nishanthr24-proj/PCB-desgning-/solar-charger-led-revB/ATTRIBUTION.md

# Sources and attribution

- Starting project: <https://github.com/Hirusha785/solar-battery-charge-controller-pcb>,
  archive supplied by the user, commit identifier in the ZIP:
  `8adcedc8ef8a8e4cd02e30468040b93200b75584`.
  Its README credits **Fernando S.M.H.G.** Rev A introduced a corrected schematic and PCB layout; Rev B adds
  input protection, test points, shutdown access, and clarified labels while
  preserving that lineage. The supplied
  archive does not include a license; no new license is asserted for upstream work.
- Revision lineage: Rev B is derived from the user's Rev A in this repository,
  retained at `../solar-charger-led-revA/` for comparison. The added engineering
  changes do not imply that any upstream author reviewed or endorsed Rev B.
- Circuit reference: Analog Devices / Linear Technology **LT3652**, datasheet
  revision `3652fe`, particularly pin functions, component selection, feedback
  compensation, status decoding, temperature monitoring, and layout guidance:
  <https://www.analog.com/media/en/technical-documentation/data-sheets/3652fe.pdf>.
  The official host was blocked by this environment's network policy. The same
  document was read from the public copy at
  <https://github.com/BEEMB/LT3652-MPPT-Solar-Battery-Charger/blob/main/Datasheets/LT3652.pdf>.
  Verify the latest manufacturer documentation and exact orderable part before assembly.
- SparkFun's SunnyBuddy LT3652 schematic was consulted to understand the uploaded
  circuit's origins: <https://github.com/sparkfun/SunnyBuddy>. Its Eagle geometry,
  artwork, and logos were not copied into this PCB. Do not imply either upstream
  author has reviewed or endorsed this revision.
- Local symbols and footprints are copies of standard **KiCad 9 libraries**,
  with project-local library nicknames. They retain the upstream library license
  and its exception. See the included `licenses/` copyright files. The project
  is not assigned a new license on the user's behalf.
- Bundled standard 3D models come from the official **KiCad packages3D** library,
  pinned to commit `b8b3cfdfad88ba66f21002b3de51dc6f7d55ba5a`:
  <https://gitlab.com/kicad/libraries/kicad-packages3D>.
  They retain **CC BY-SA 4.0 with the KiCad library design exception**; see
  [licenses/kicad-packages3D-LICENSE.md](licenses/kicad-packages3D-LICENSE.md).
  [3dmodels/SOURCES.json](3dmodels/SOURCES.json) records individual model sources.
  L1's locally created representative body and the representative U1 package
  dimensions are described in [3D/README.md](3D/README.md). These are visualization
  models, not manufacturer validation of the selected components.
- The user-supplied **DC-DC-Buck-converter-main.zip**, archive commit
  `8b01752160c50a88990ef84c027424b66262864f`, inspired the populated front/back
  presentation views. Its README credits **Nandeesh K S**. No reference-board
  geometry, artwork, or component model files were copied into Rev B.
- Protection components: F1 and D5 are specified by required ratings and package
  class. Verify the chosen fuse's DC voltage/interrupt ratings and land pattern,
  and the chosen diode's current/voltage/thermal ratings, against the actual
  manufacturer documents before purchase. No unverified manufacturer part number
  is asserted as a drop-in substitute.
- No LT3652 manufacturer simulation model was used for Rev B and no simulation
  result is presented as Rev B verification. Physical tests have not been performed.
