nishanthr24-proj/PCB-desgning-/solar-charger-led-revB/previews/PCB_3D_Top.png

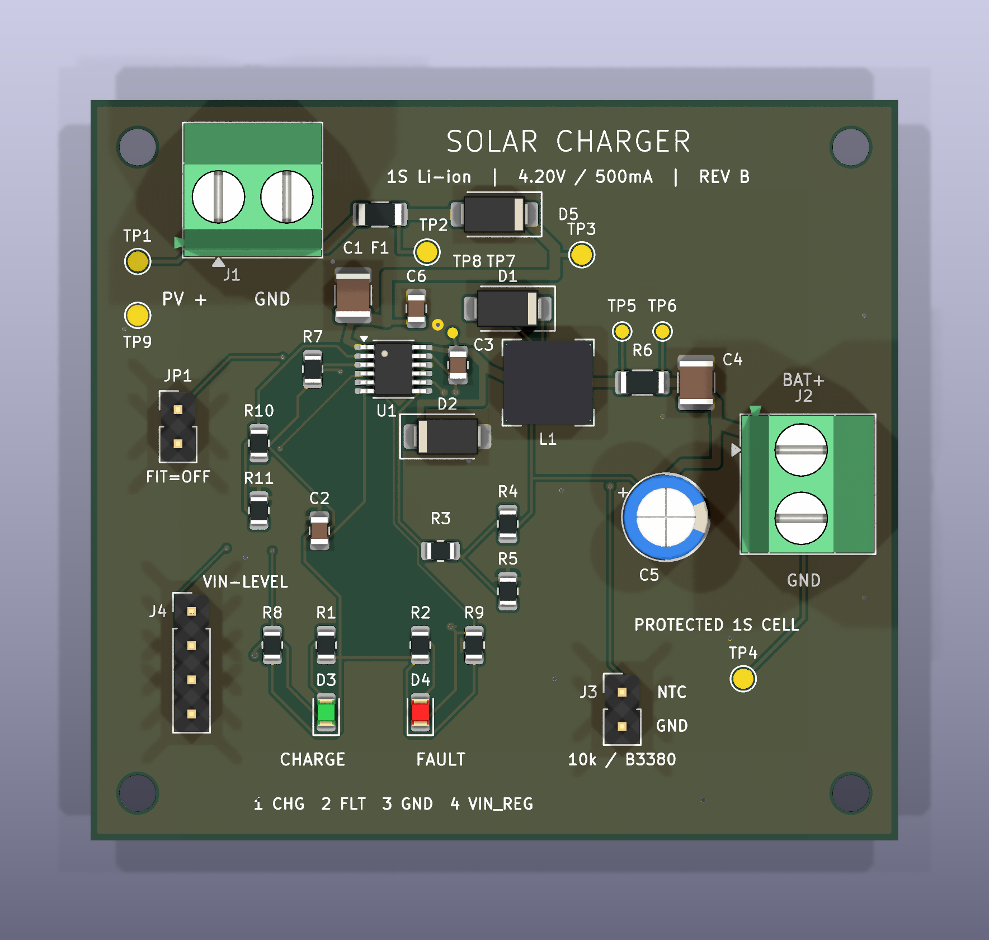
solar-charger-led-revB/previews/PCB_3D_Top.png
