nishanthr24-proj/PCB-desgning-/solar-charger-led-revB/previews/Schematic.png

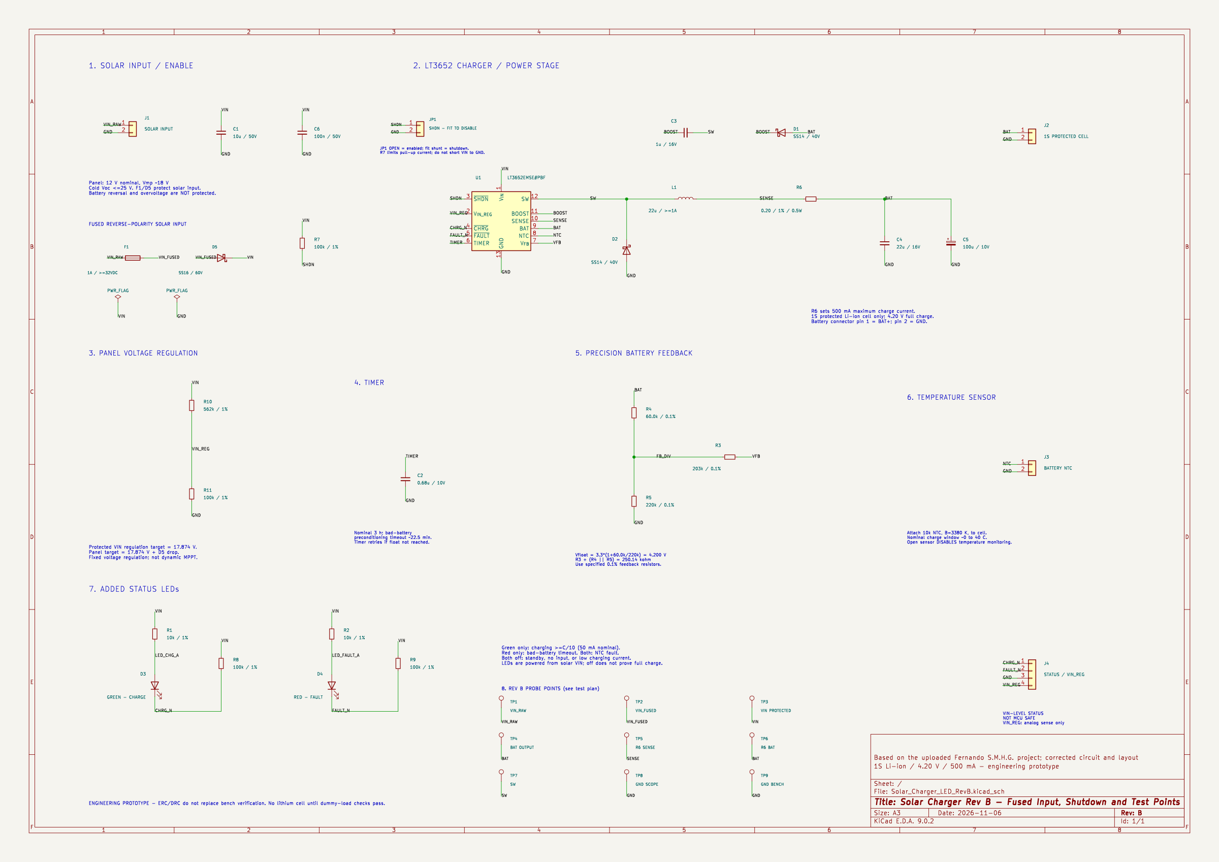
solar-charger-led-revB/previews/Schematic.png
