nishanthr24-proj/PCB-desgning-/solar-charger-led-revB/3D/Solar_Charger_LED_RevB_Assembly.step

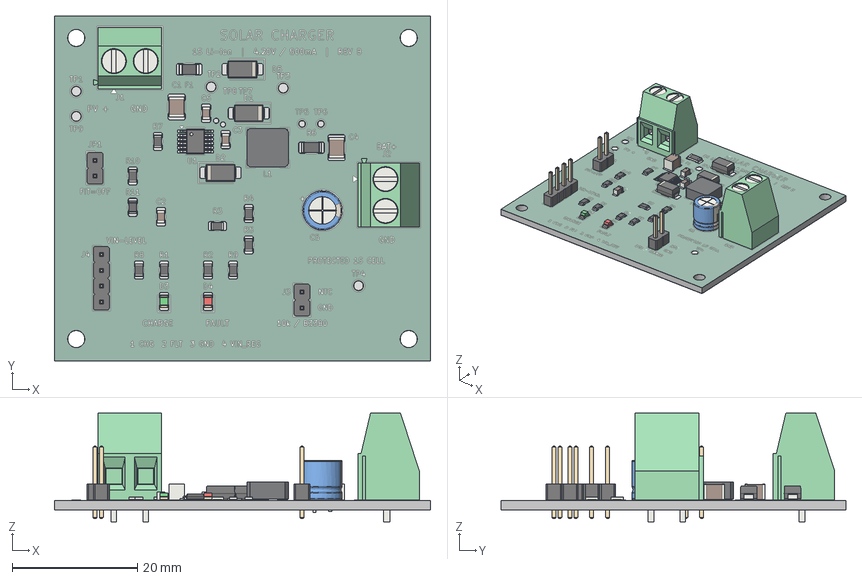
[picture p5: CAD file, 2026-11-06]
solar-charger-led-revB/3D/Solar_Charger_LED_RevB_Assembly.step
60.0 x 55.0 x 17.3 mm
LED_0805_Green_Display
TerminalBlock_Phoenix_MKDS-1,5-2-5.08_1x02_P5.08mm_Horizontal x 2
R_0805_2012Metric x 10
C_0805_2012Metric x 3
PinHeader_1x02_P2.54mm_Vertical x 2
C_1210_3225Metric x 2
PinHeader_1x04_P2.54mm_Vertical
LED_0805_Red_Display
Fuse_1206_3216Metric
D_SMA x 3
MSOP-12_3x4mm_Representative
L_Bourns-SRN6028_Envelope
R_1206_3216Metric
CP_Radial_D6.3mm_P2.50mm
Solar_Charger_LED_RevB_pad
Solar_Charger_LED_RevB_silkscreen
Solar_Charger_LED_RevB_soldermask
Solar_Charger_LED_RevB_PCB
