nishanthr24-proj/PCB-desgning-/solar-charger-led-revB/manufacturing/README.txt

REV B ENGINEERING PROTOTYPE. Two layers; 60 x 55 mm; 1.6 mm FR4; 1 oz copper.
Minimum track/clearance 0.15 mm; minimum signal via diameter/drill 0.45/0.20 mm.
Four 0.60/0.30 mm thermal vias under U1. Confirm exposed-pad assembly and solder-wicking mitigation.
F1/D5 protect the solar-input path only. Verify actual component ratings/land patterns before ordering.
TP7/TP8 are small 0.8 mm probe pads; no part is fitted. Leave JP1 shunt off for charging.
These outputs are from the CAD-checked Rev B board, NOT from Rev A.
No physical tests have been performed. Read README.md and TEST_PLAN.md before ordering or applying power.
