nishanthr24-proj/PCB-desgning-/solar-charger-led-revA/manufacturing/README.txt

REV A ENGINEERING PROTOTYPE. Two layers; 60 x 55 mm; 1.6 mm FR4; 1 oz copper.
Minimum track/clearance 0.15 mm. Minimum signal via 0.45 mm diameter / 0.20 mm drill.
Four 0.60/0.30 mm thermal vias under U1. Confirm fabrication and exposed-pad assembly process.
Gerbers and Excellon drill generated from the CAD-checked Rev A board.
No physical tests have been performed. Read the main README before ordering or powering a board.
