nishanthr24-proj/PCB-desgning-/solar-charger-led-revB/previews/Schematic.pdf

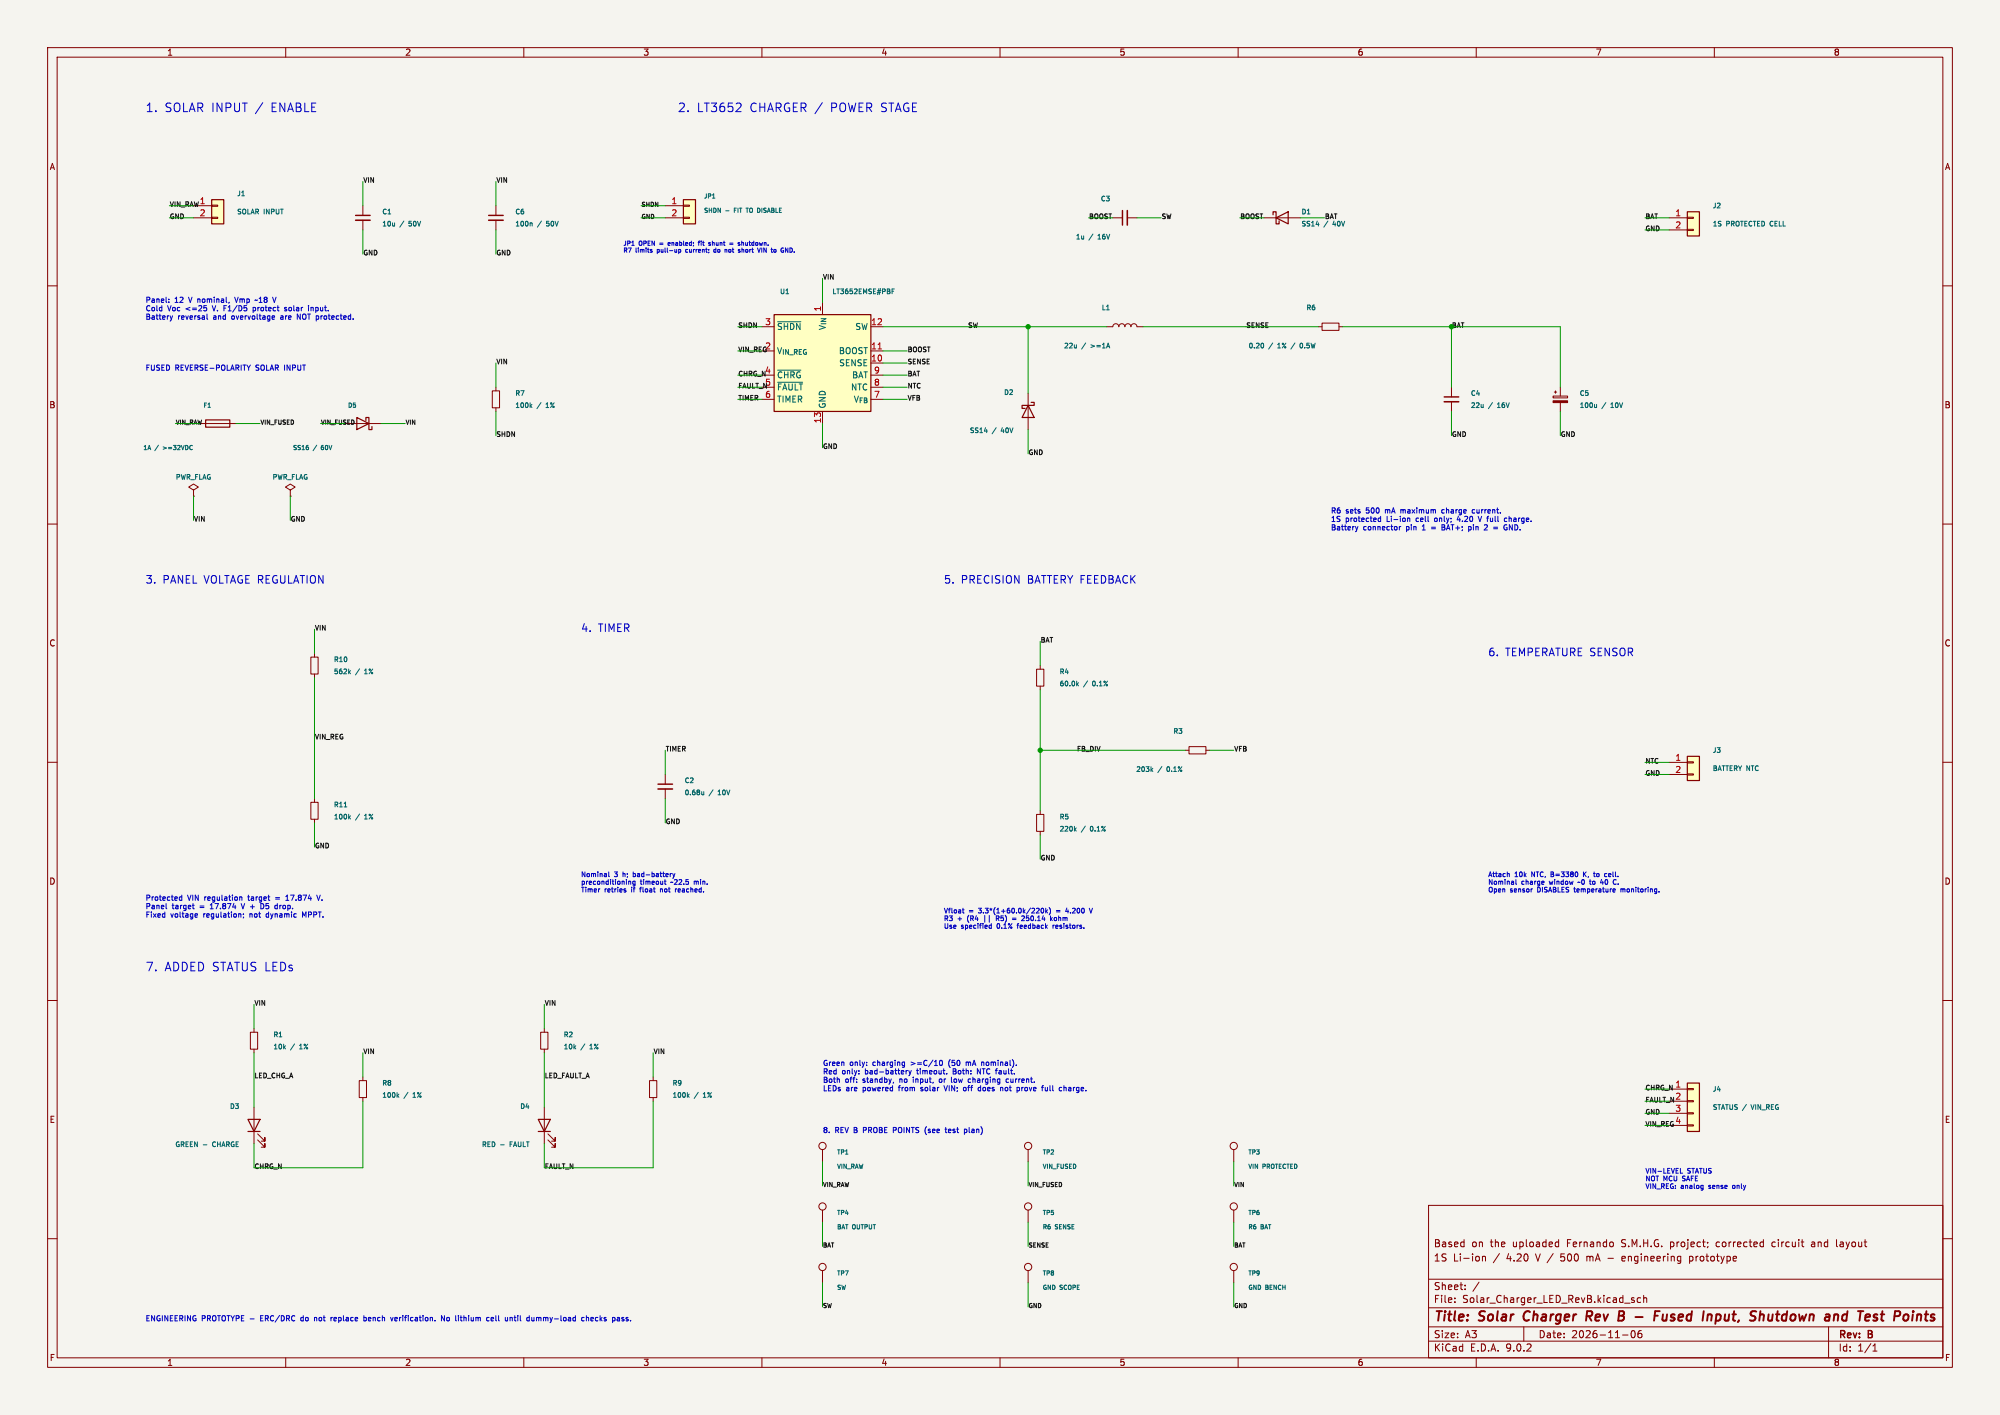
[picture p6: page 1]

JP1 SHDN - FIT TO DISABLE

Id: 1/1 Title: Solar Charger Rev B - Fused Input, Shutdown and Test Points
