nishanthr24-proj/PCB-desgning-/solar-charger-led-revB/previews/Assembly.pdf

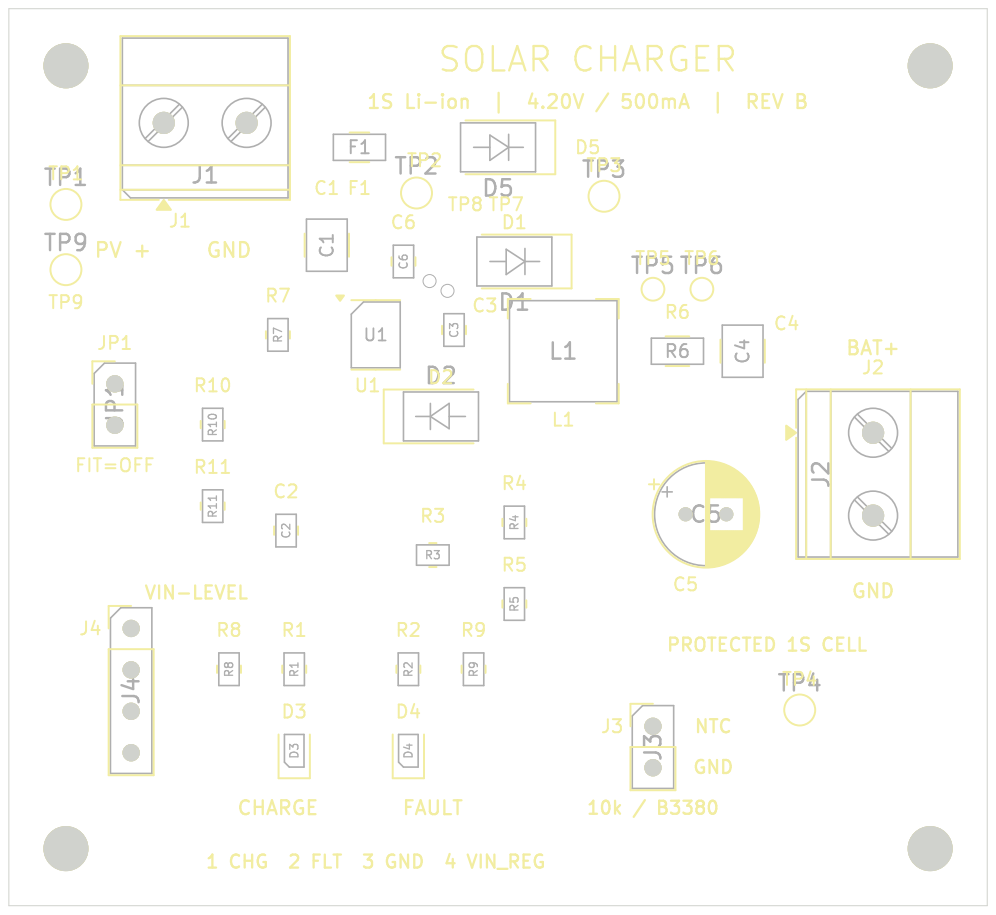
[picture p7: page 1]
