nishanthr24-proj/PCB-desgning-/solar-charger-led-revA/previews/Schematic.pdf

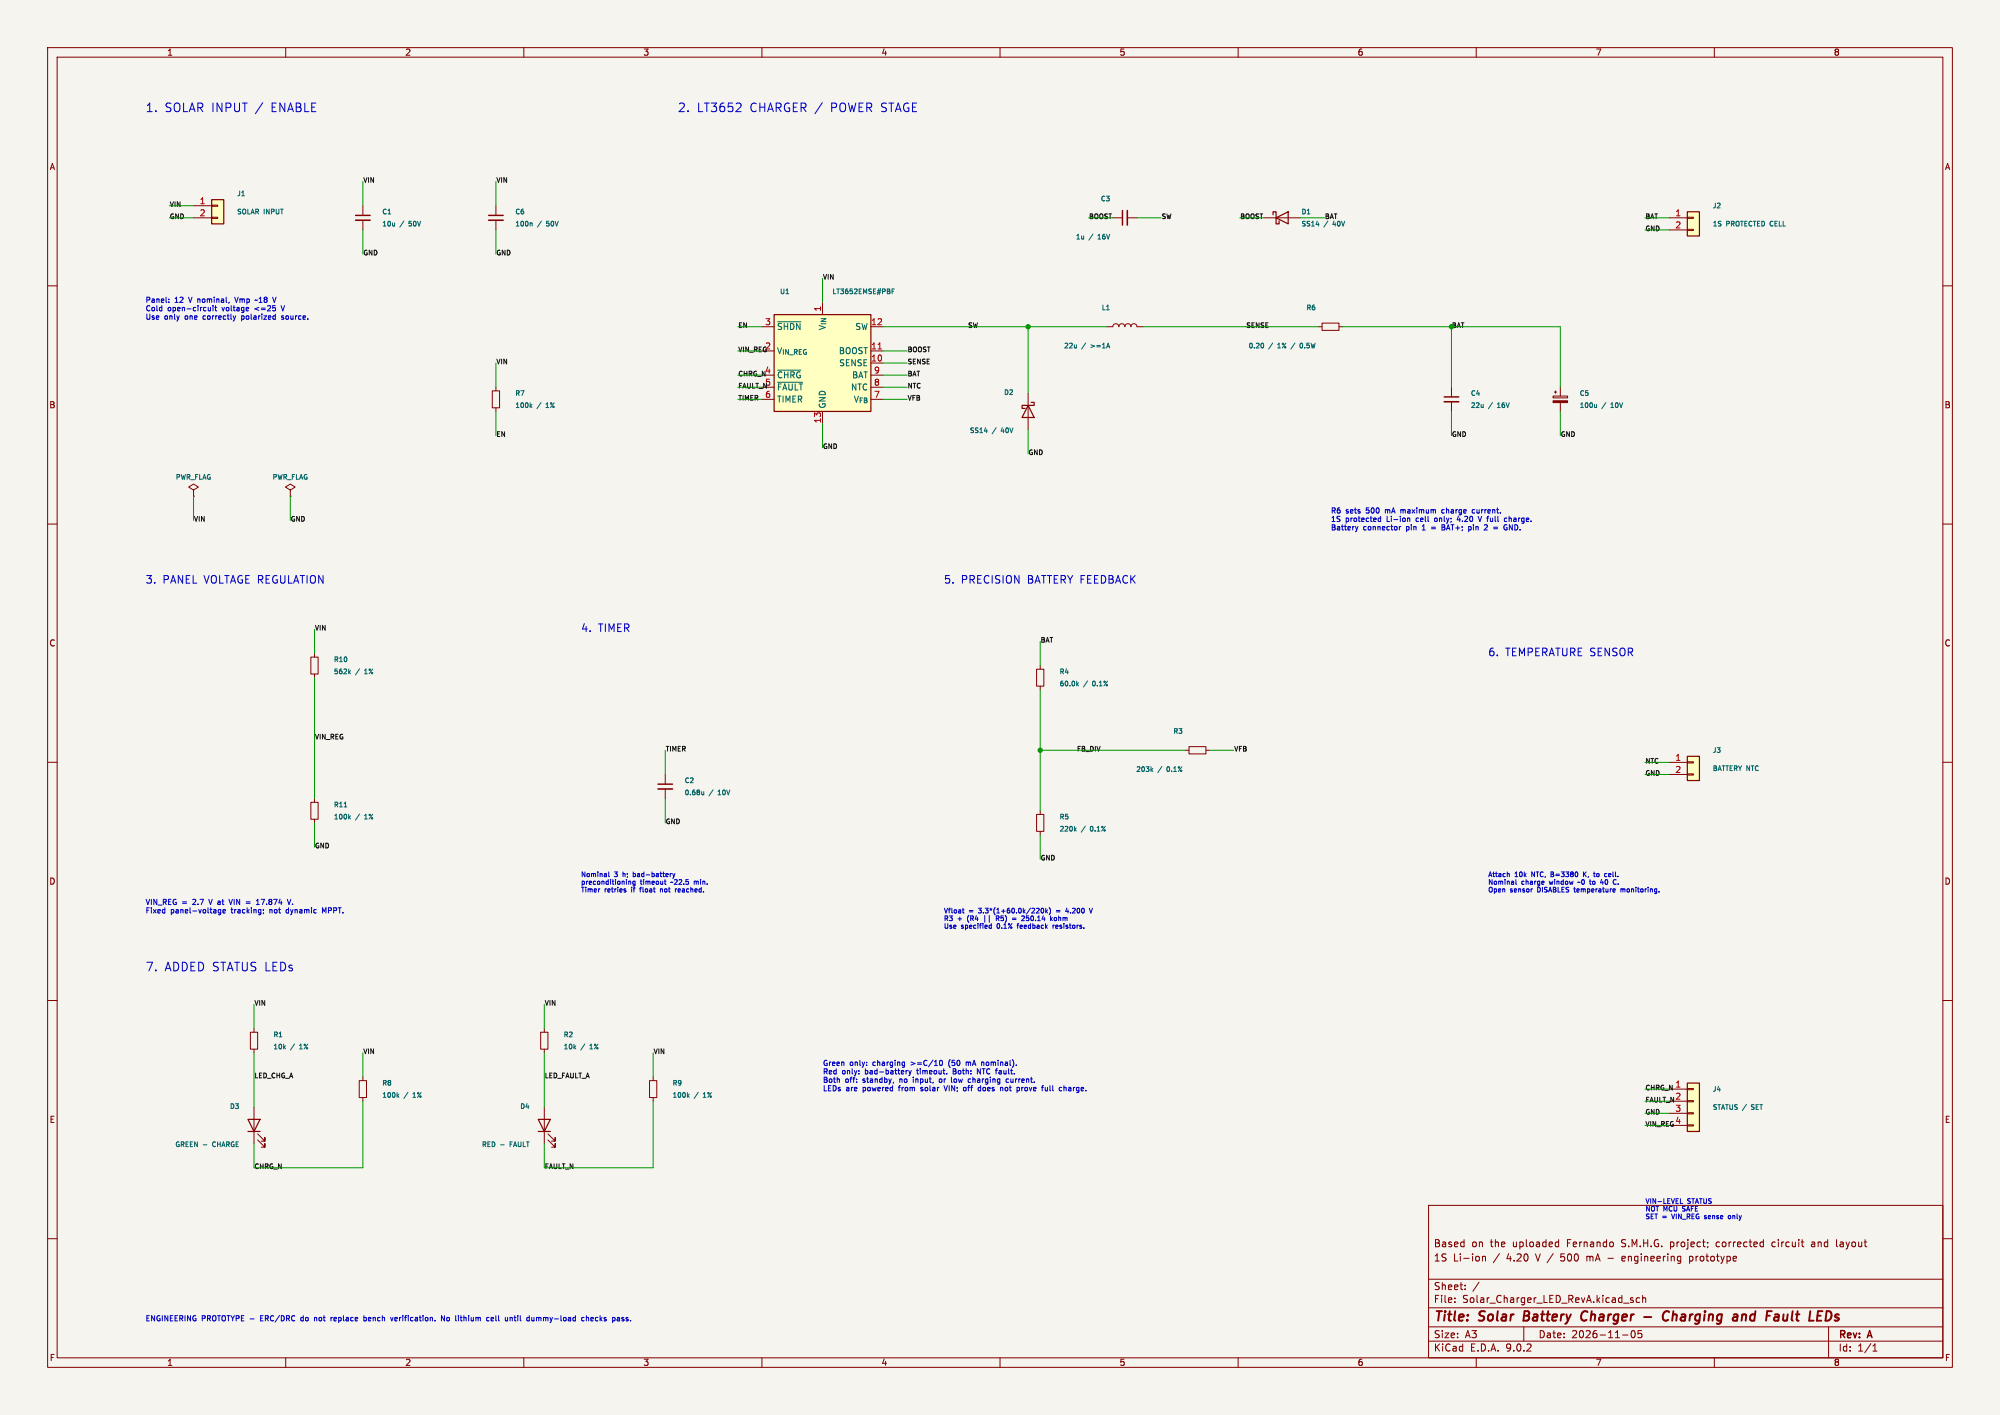
[picture p8: page 1]

Id: 1/1 Title: Solar Battery Charger - Charging and Fault LEDs
