nishanthr24-proj/PCB-desgning-/solar-charger-led-revA/previews/Assembly.pdf

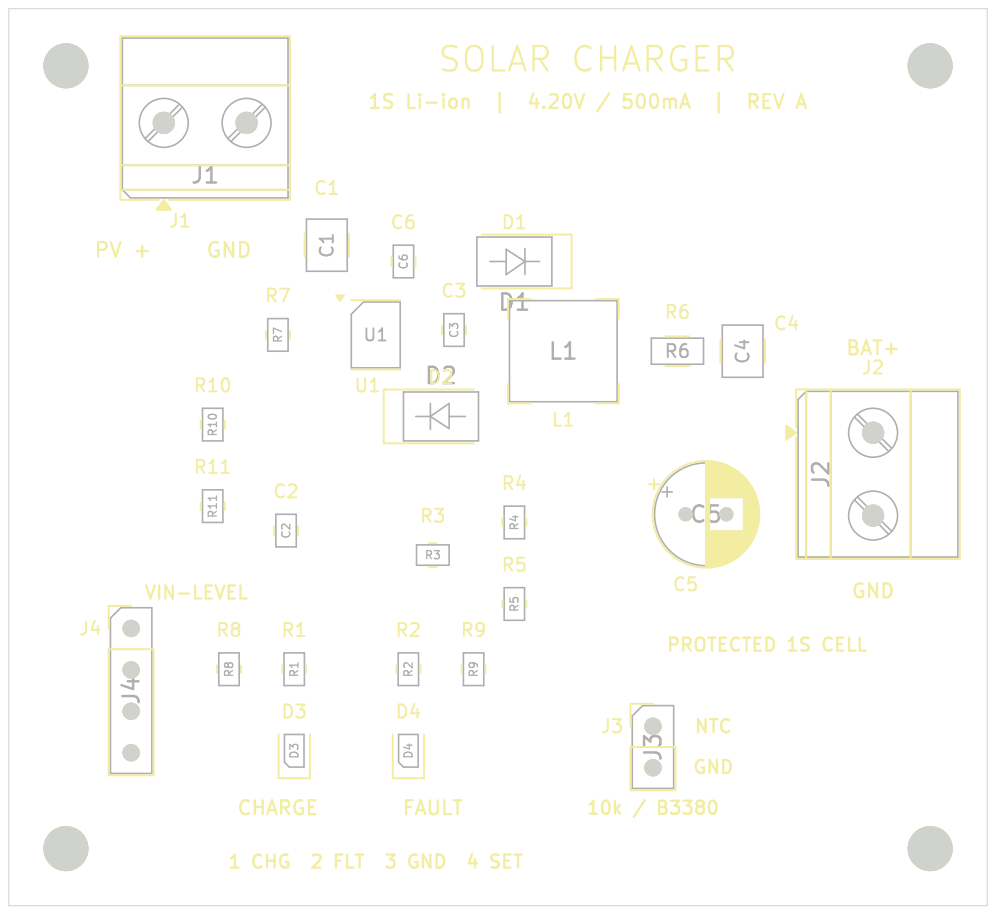
[picture p9: page 1]
