nishanthr24-proj/PCB-desgning-/solar-charger-led-revB/Solar_Charger_LED_RevB.kicad_pcb

## KiCad design solar-charger-led-revB/Solar_Charger_LED_RevB.kicad_pcb (2026-11-06)

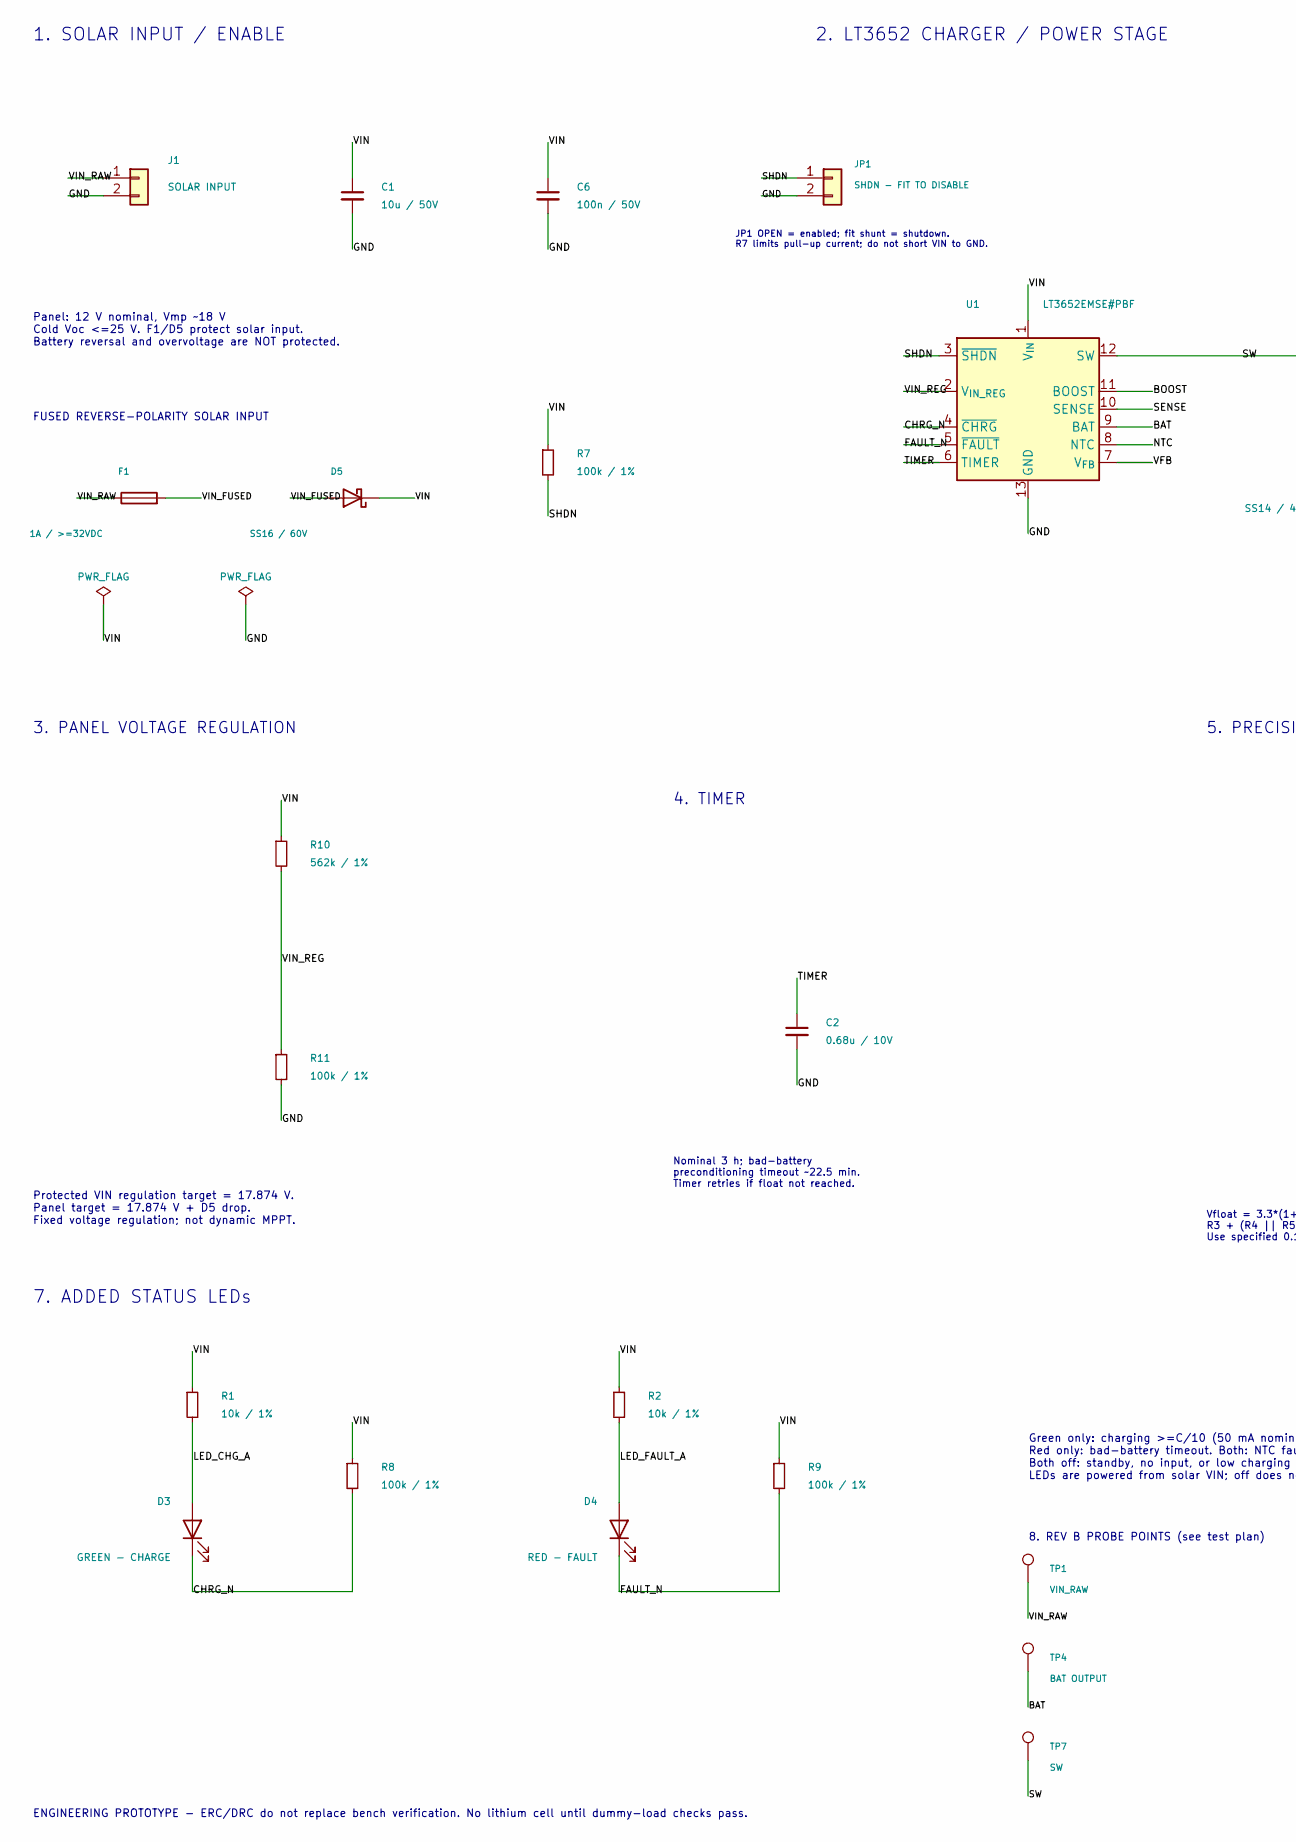
[picture p10: schematic Solar_Charger_LED_RevB.kicad_sch, Solar Charger Rev B - Fused Input, Shutdown and Test Points, part in row 1, column 1]

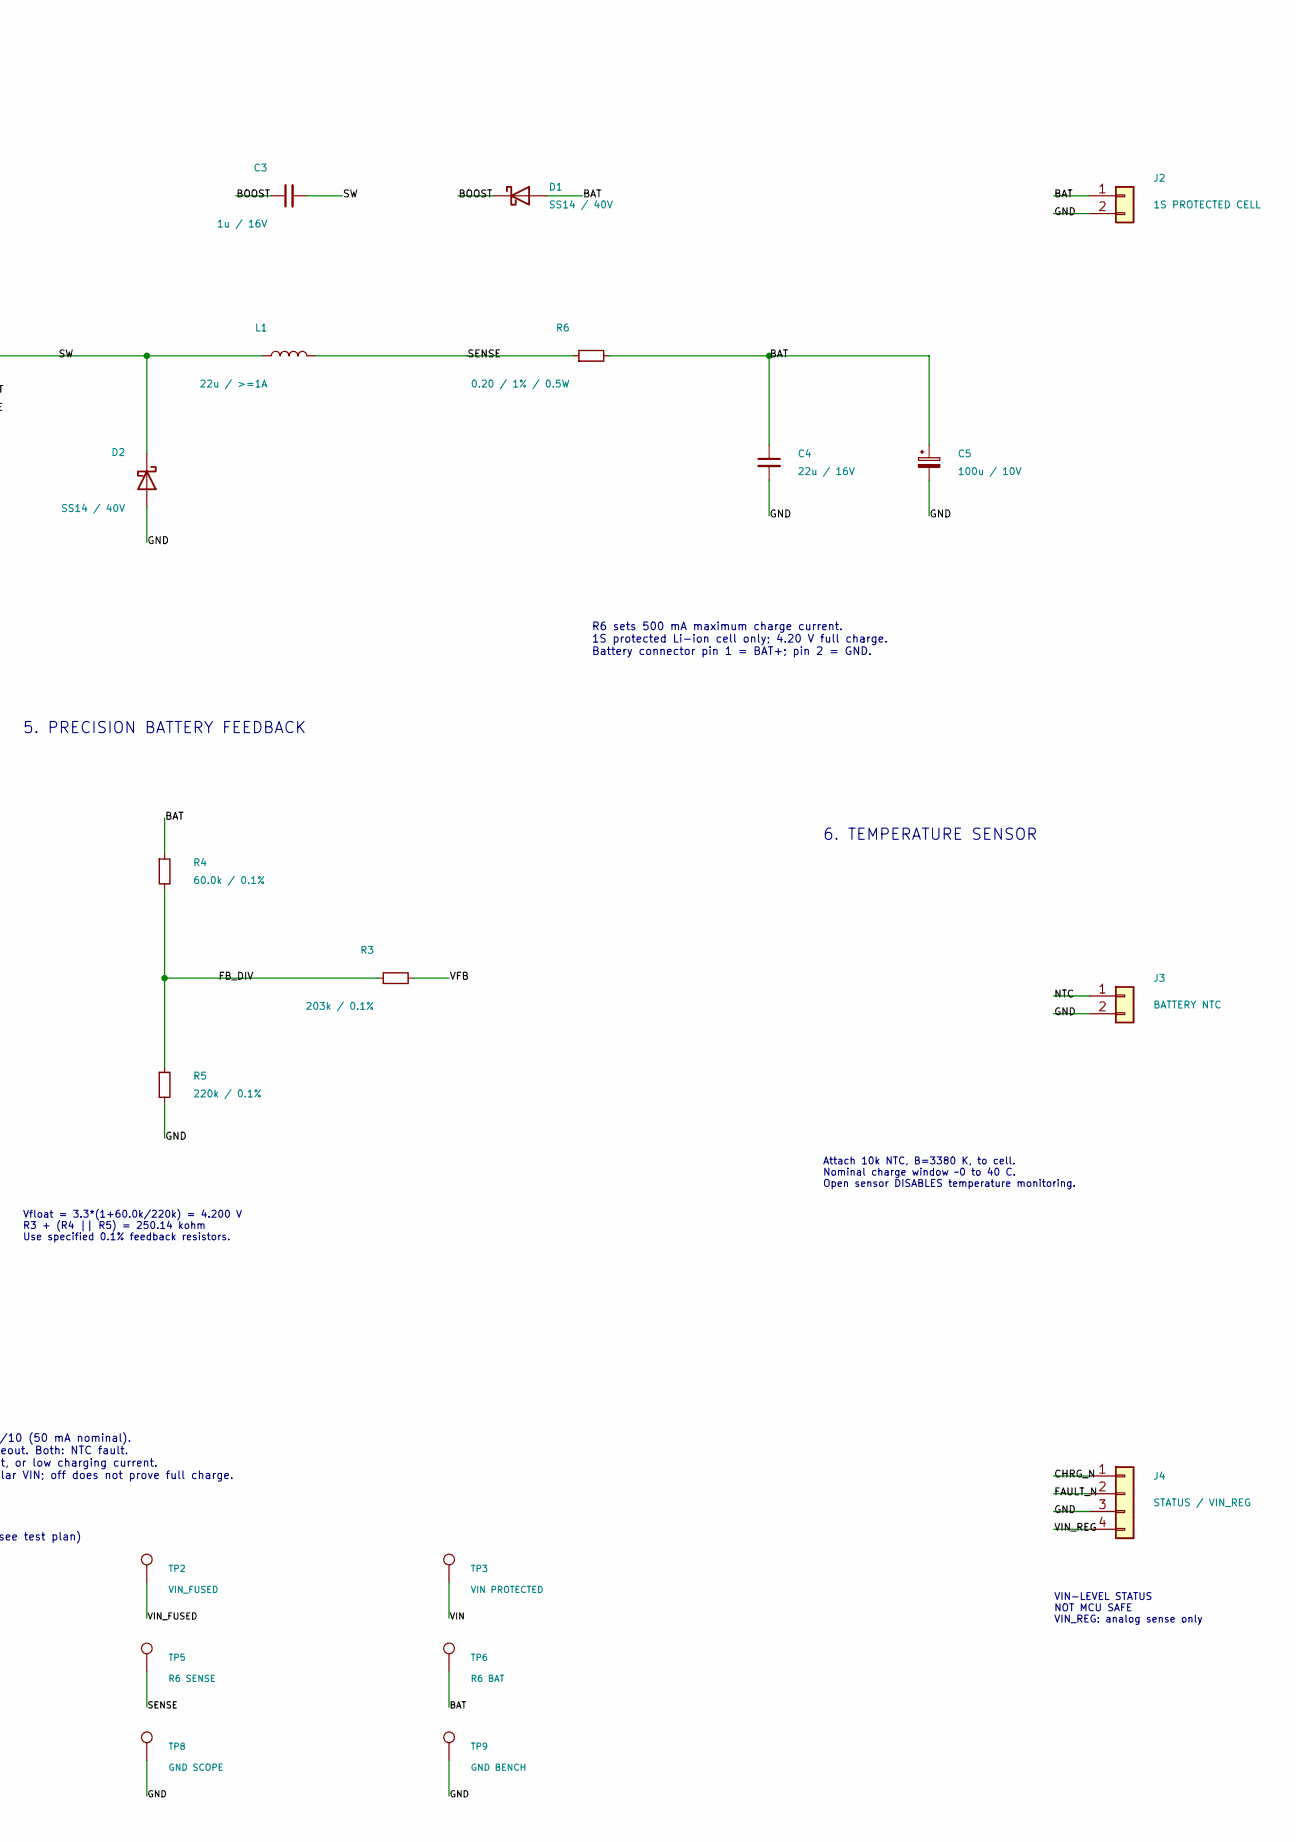
[picture p11: schematic Solar_Charger_LED_RevB.kicad_sch, Solar Charger Rev B - Fused Input, Shutdown and Test Points, part in row 1, column 2]

Parts:
C1: 10u / 50V; C_1210_3225Metric
C2: 0.68u / 10V; C_0805_2012Metric
C3: 1u / 16V; C_0805_2012Metric
C4: 22u / 16V; C_1210_3225Metric
C5: 100u / 10V; CP_Radial_D6.3mm_P2.50mm
C6: 100n / 50V; C_0805_2012Metric
D1, D2: SS14 / 40V; D_SMA; MPN SS14
D3: GREEN - CHARGE; LED_0805_2012Metric
D4: RED - FAULT; LED_0805_2012Metric
D5: SS16 / 60V; D_SMA; MPN SS16 (SMA, verify vendor datasheet)
F1: 1A / >=32VDC; Fuse_1206_3216Metric
J1: SOLAR INPUT; TerminalBlock_Phoenix_MKDS-1,5-2-5.08_1x02_P5.08mm_Horizont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
J2: 1S PROTECTED CELL; TerminalBlock_Phoenix_MKDS-1,5-2-5.08_1x02_P5.08mm_Horizont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
J3: BATTERY NTC; PinHeader_1x02_P2.54mm_Vertical
J4: STATUS / VIN_REG; PinHeader_1x04_P2.54mm_Vertical
JP1: SHDN - FIT TO DISABLE; PinHeader_1x02_P2.54mm_Vertical
L1: 22u / >=1A; L_Bourns-SRN6028; MPN SRN6028-220M
R1, R2: 10k / 1%; R_0805_2012Metric
R3: 203k / 0.1%; R_0805_2012Metric
R4: 60.0k / 0.1%; R_0805_2012Metric
R5: 220k / 0.1%; R_0805_2012Metric
R6: 0.20 / 1% / 0.5W; R_1206_3216Metric
R7, R8, R9, R11: 100k / 1%; R_0805_2012Metric
R10: 562k / 1%; R_0805_2012Metric
TP1: VIN_RAW; TestPoint_Pad_D1.5mm
TP2: VIN_FUSED; TestPoint_Pad_D1.5mm
TP3: VIN PROTECTED; TestPoint_Pad_D1.5mm
TP4: BAT OUTPUT; TestPoint_Pad_D1.5mm
TP5: R6 SENSE; TestPoint_Pad_D1.0mm
TP6: R6 BAT; TestPoint_Pad_D1.0mm
TP7: SW; ProbePad_D0.8mm
TP8: GND SCOPE; ProbePad_D0.8mm
TP9: GND BENCH; TestPoint_Pad_D1.5mm
U1: LT3652EMSE#PBF; MSOP-12-1EP_3x4.039mm_P0.65mm_EP1.651x2.845mm; MPN LT3652EMSE#PBF

Connections:
/BAT: C4.1, C5.1, D1.2 (A), J2.1, R4.1, R6.2, TP4.1, TP6.1, U1.9 (BAT)
/BOOST: C3.1, D1.1 (K), U1.11 (BOOST)
/CHRG_N: D3.1 (K), J4.1, R8.2, U1.4 (~CHRG)
/FAULT_N: D4.1 (K), J4.2, R9.2, U1.5 (~FAULT)
/FB_DIV: R3.1, R4.2, R5.1
/GND: C1.2, C2.2, C4.2, C5.2, C6.2, D2.2 (A), J1.2, J2.2, J3.2, J4.3, JP1.2, R5.2, R11.2, TP8.1, TP9.1, U1.13 (GND)
/LED_CHG_A: D3.2 (A), R1.2
/LED_FAULT_A: D4.2 (A), R2.2
/NTC: J3.1, U1.8 (NTC)
/SENSE: L1.2, R6.1, TP5.1, U1.10 (SENSE)
/SHDN: JP1.1, R7.2, U1.3 (~SHDN)
/SW: C3.2, D2.1 (K), L1.1, TP7.1, U1.12 (SW)
/TIMER: C2.1, U1.6 (TIMER)
/VFB: R3.2, U1.7 (V_{FB})
/VIN: C1.1, C6.1, D5.1 (K), R1.1, R2.1, R7.1, R8.1, R9.1, R10.1, TP3.1, U1.1 (V_{IN})
/VIN_FUSED: D5.2 (A), F1.2, TP2.1
/VIN_RAW: F1.1, J1.1, TP1.1
/VIN_REG: J4.4, R10.2, R11.1, U1.2 (V_{IN_REG})

Notes on the sheet:
1. SOLAR INPUT / ENABLE
Panel: 12 V nominal, Vmp ~18 V Cold Voc <=25 V. F1/D5 protect solar input. Battery reversal and overvoltage are NOT protected.
2. LT3652 CHARGER / POWER STAGE
R6 sets 500 mA maximum charge current. 1S protected Li-ion cell only; 4.20 V full charge. Battery connector pin 1 = BAT+; pin 2 = GND.
3. PANEL VOLTAGE REGULATION
Protected VIN regulation target = 17.874 V. Panel target = 17.874 V + D5 drop. Fixed voltage regulation; not dynamic MPPT.
4. TIMER
Nominal 3 h; bad-battery preconditioning timeout ~22.5 min. Timer retries if float not reached.
5. PRECISION BATTERY FEEDBACK
Vfloat = 3.3*(1+60.0k/220k) = 4.200 V R3 + (R4 || R5) = 250.14 kohm Use specified 0.1% feedback resistors.
6. TEMPERATURE SENSOR
Attach 10k NTC, B=3380 K, to cell. Nominal charge window ~0 to 40 C. Open sensor DISABLES temperature monitoring.
7. ADDED STATUS LEDs
Green only: charging >=C/10 (50 mA nominal). Red only: bad-battery timeout. Both: NTC fault. Both off: standby, no input, or low charging current. LEDs are powered from solar VIN; off does not prove full charge.
VIN-LEVEL STATUS NOT MCU SAFE VIN_REG: analog sense only
ENGINEERING PROTOTYPE - ERC/DRC do not replace bench verification. No lithium cell until dummy-load checks pass.
FUSED REVERSE-POLARITY SOLAR INPUT
JP1 OPEN = enabled; fit shunt = shutdown. R7 limits pull-up current; do not short VIN to GND.
8. REV B PROBE POINTS (see test plan)

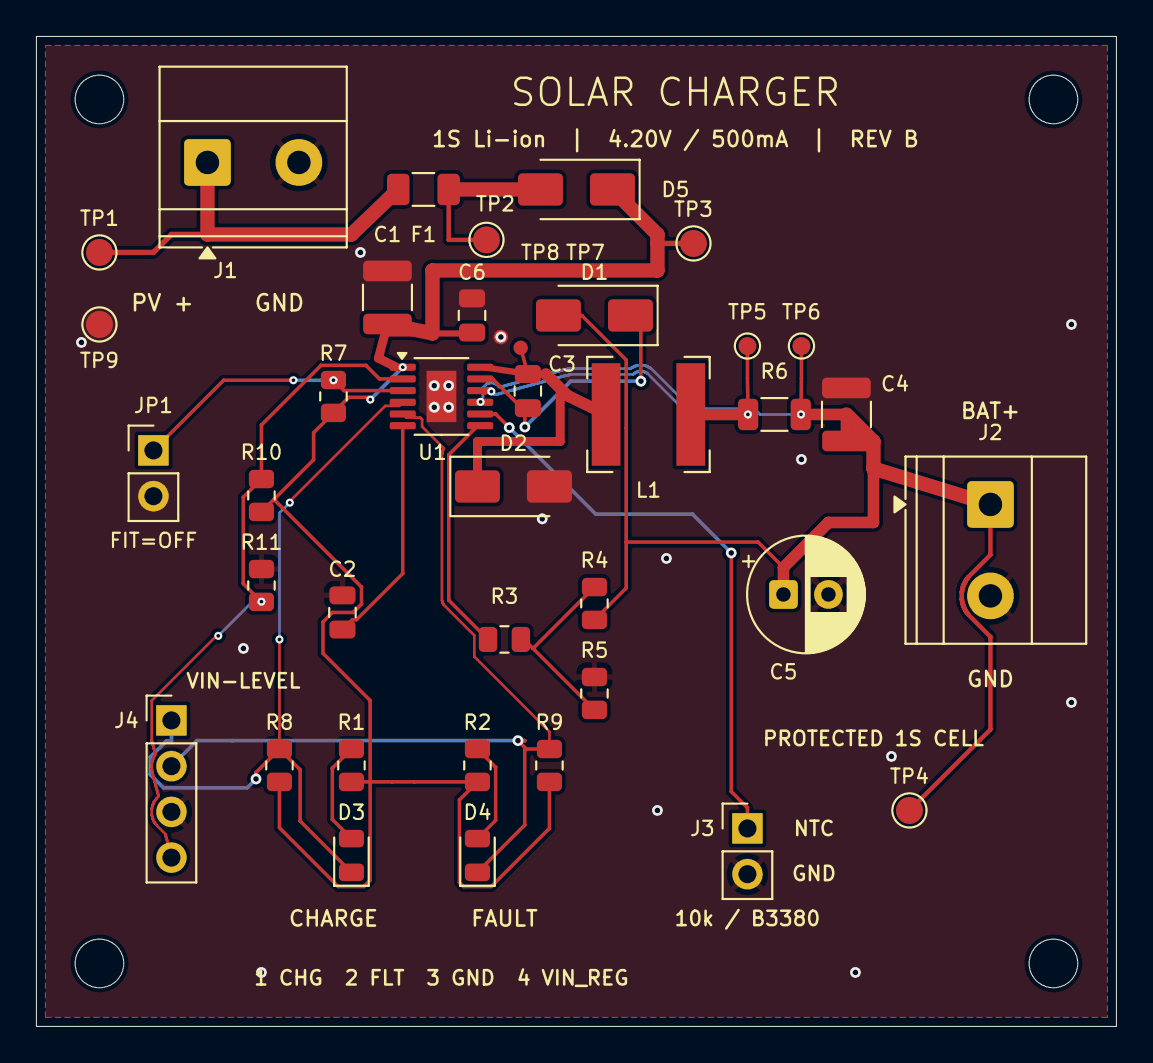
[picture p12: board Solar_Charger_LED_RevB.kicad_pcb from above]

Board: 2 copper layers, 60.0 x 55.0 mm, 43 parts (0 on the bottom side), 18 nets.

Other parts of the board:
H1, H2, H3, H4: MountingHole_2.7mm_M2.5
