nishanthr24-proj/PCB-desgning-/(commit log)

2026-11-05 Add solar charger KiCad design with charge and fault LEDs
    [BOM.csv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]
2026-11-05 Add solar charger behavioral simulations and offline viewer
    [01_normal_charge.csv, 02_temperature_faults.csv, 03_sunlight_changes.csv, 04_bad_battery.csv, 05_preconditioning.csv, 06_load_restart.csv, 07_sensor_open.csv]
2026-11-05 Remove simulation demonstration and README links
    [01_normal_charge.csv, 02_temperature_faults.csv, 03_sunlight_changes.csv, 04_bad_battery.csv, 05_preconditioning.csv, 06_load_restart.csv, 07_sensor_open.csv]
2026-11-06 Add Rev B input protection, shutdown jumper and probe points
    [BOM.csv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]
2026-11-06 Add portable populated 3D assembly and presentation views for Rev B
    [Solar_Charger_LED_RevB.kicad_pcb, Solar_Charger_LED_RevB_Assembly.step]
